ris2021/CRISS/HARDWARE/GPIO-LPT-ASS.png

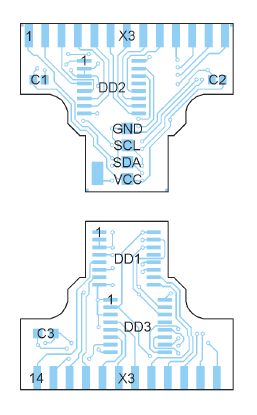
HARDWARE/GPIO-LPT-ASS.png
