ris2021/CRISS/HARDWARE/GPIO-LPT.png

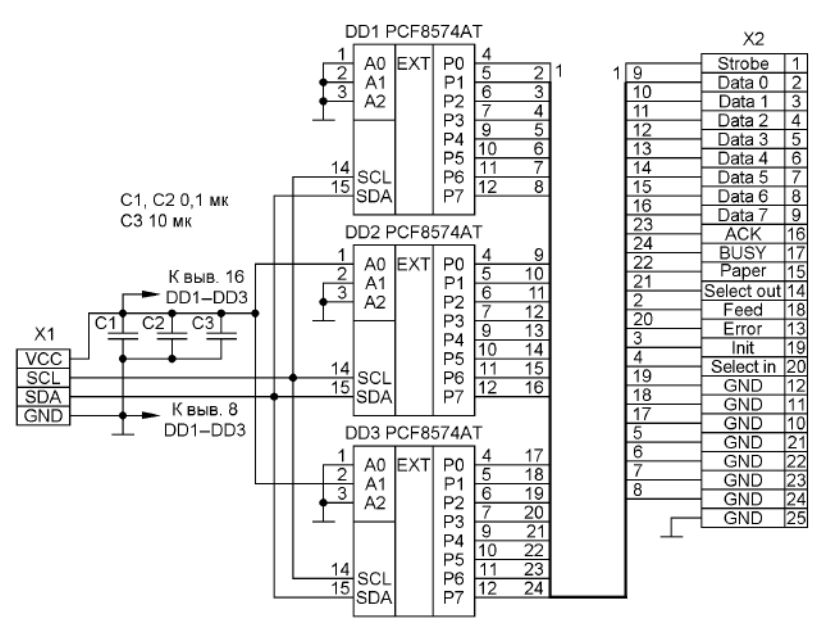
HARDWARE/GPIO-LPT.png
