ris2021/CRISS/HARDWARE/schematic9.png

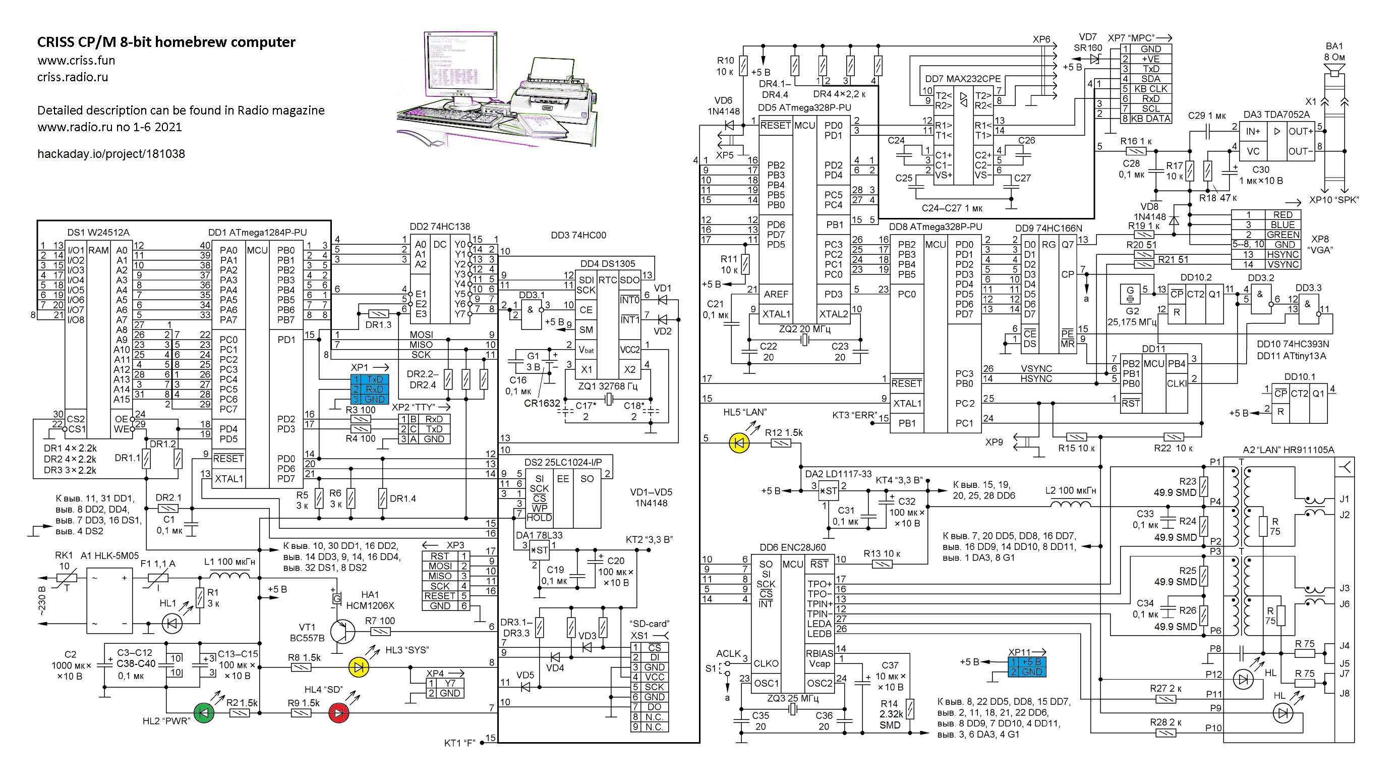
HARDWARE/schematic9.png
