ris2021/CRISS/(list of files, cad)

Other CAD files:
VGA-AT13/at13.obj
