ris2021/CRISS/HARDWARE/PCB_317_assembling_3.png

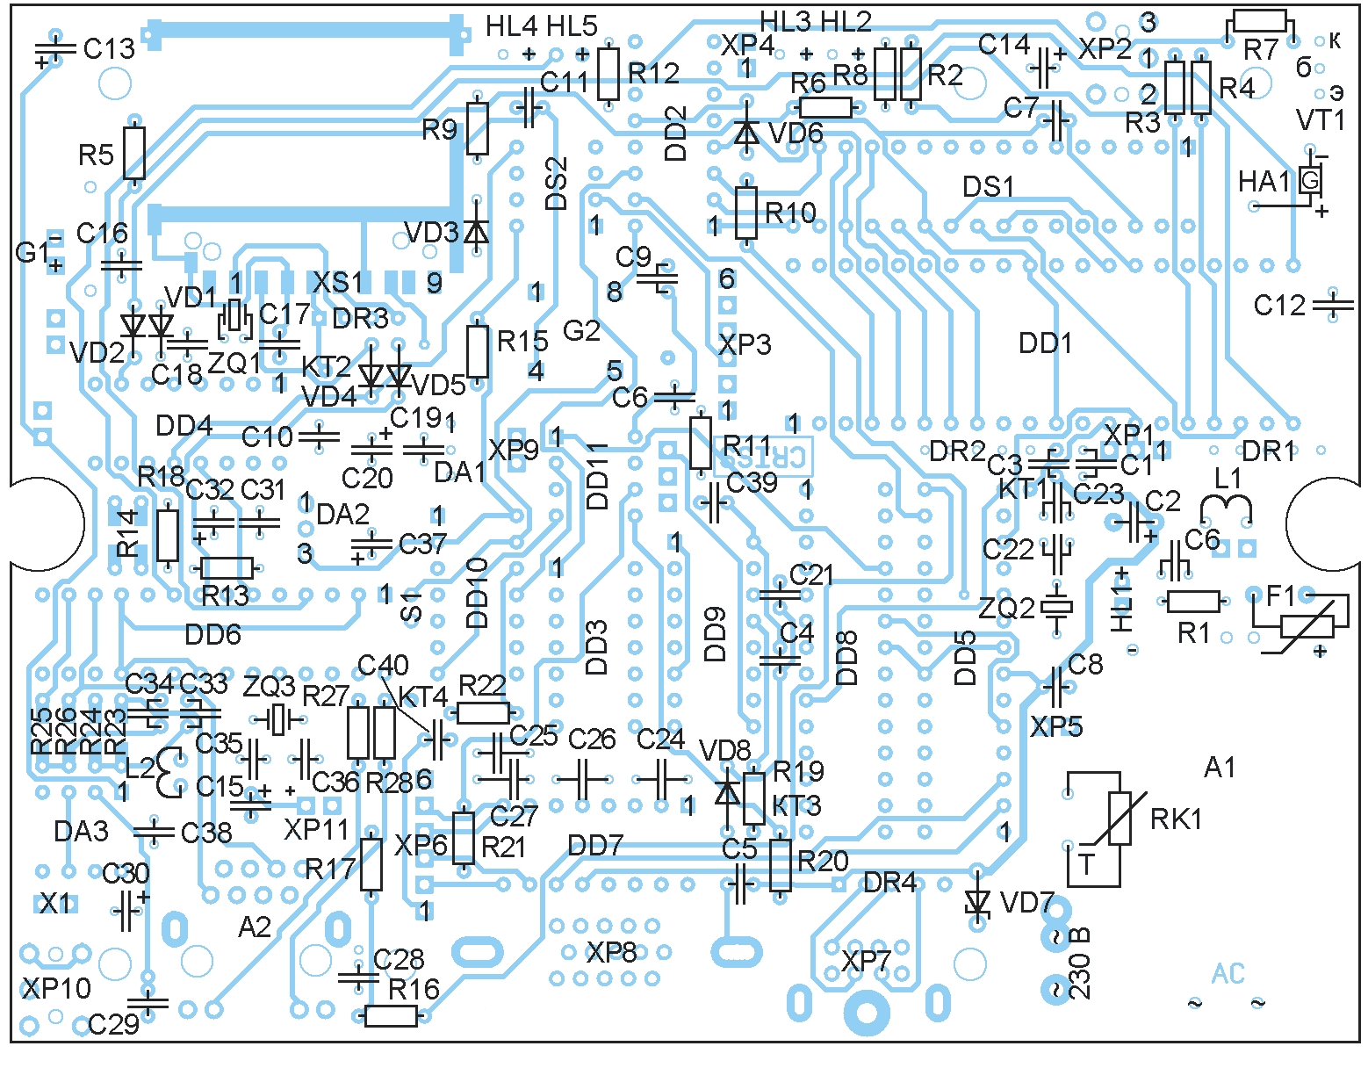
HARDWARE/PCB_317_assembling_3.png
