ris2021/CRISS/FIRMWARE/VGA/v.1.24/changelog.txt

1.24 16.01.2023
----------------------------------------------------------------------------------------
* fixed bug with special mode settings

1.23 04.02.2022
----------------------------------------------------------------------------------------
+ добавлены видережимы 30 и 31 строки с выводом 64 символов в строке
* установки CBYTE вынесена в процедуру

1.22 05.11.2021
----------------------------------------------------------------------------------------
* переписана логика управления кодовыми страницами
+ добавлен режим кодовой страницы 7 - своя КП для каждой строки (в строке 25)

1.21 04.10.2021
----------------------------------------------------------------------------------------
+ добавлен режим отключения синхроимпульсов при vstat=0

1.18 24.02.2021
----------------------------------------------------------------------------------------
* исправлена ошибка - не работала первичная настройка видеорежима
* заменён стартовый экран на cpm inside

1.17 22.02.2021
----------------------------------------------------------------------------------------
* дополнены шрифты CP0, CP2

1.16 19.02.2021
----------------------------------------------------------------------------------------
+ добавлена инициализация PC1 low при старте

1.14 30.01.2021
----------------------------------------------------------------------------------------
+ в стартовом экране первый байт теперь = настройка видеорежима
+ в обработчик стартовой страницы добавнеа обработка табуляции #9

1.13 28.01.2021
----------------------------------------------------------------------------------------
+ добавлен шрифт с меликми точками (#4)

1.11. 22.01.2021
----------------------------------------------------------------------------------------
+ Запущено переключение числа строк и знакогенератора

v.1.7 22.09.2020
----------------------------------------------------------------------------------------
+ Добавлено сохранение SREG в прерываниях, выделен регистр _sreg для сохранения
