ris2021/CRISS/HARDWARE/Panels.pdf

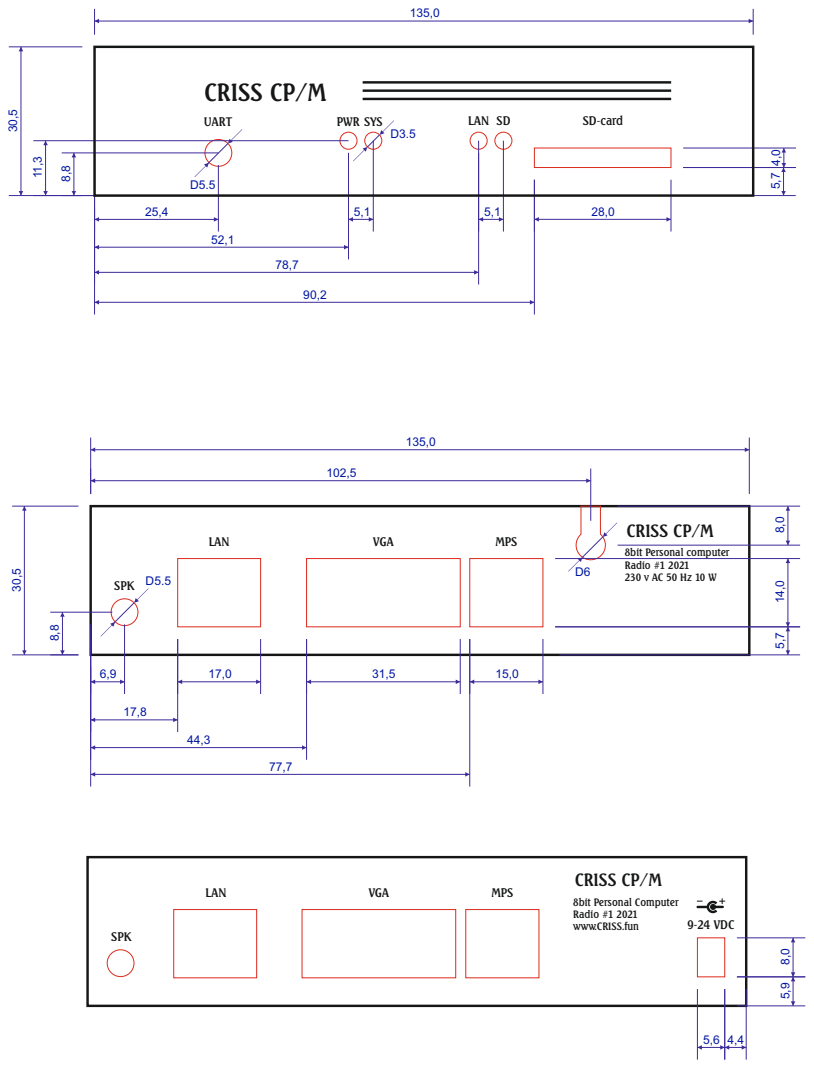
[picture p7: page 1]
SPK; CRISS CP/M LAN; VGA; MPS; 8bit Personal computer Radio #1 2021 230 v AC 50 Hz 10 W; UART; PWR SYS; LAN SD; SD-card; CRISS CP/M; LAN; 8bit Personal Computer Radio #1 2021; www.CRISS.fun; 9-24 VDC
