ris2021/CRISS/FIRMWARE/CPU/v.4.66/z80/z80_asm_ecseg.asm

zOPCODE__LABELS_L: .DB low(zCMD_00),low(zCMD_01),low(zCMD_02),low(zCMD_03),low(zCMD_04),low(zCMD_05),low(zCMD_06),low(zCMD_07),low(zCMD_08),low(zCMD_09),low(zCMD_0a),low(zCMD_0b),low(zCMD_0c),low(zCMD_0d),low(zCMD_0e),low(zCMD_0f),low(zCMD_10),low(zCMD_11),low(zCMD_12),low(zCMD_13),low(zCMD_14),low(zCMD_15),low(zCMD_16),low(zCMD_17),low(zCMD_18),low(zCMD_19),low(zCMD_1a),low(zCMD_1b),low(zCMD_1c),low(zCMD_1d),low(zCMD_1e),low(zCMD_1f),low(zCMD_20),low(zCMD_21),low(zCMD_22),low(zCMD_23),low(zCMD_24),low(zCMD_25),low(zCMD_26),low(zCMD_27),low(zCMD_28),low(zCMD_29),low(zCMD_2a),low(zCMD_2b),low(zCMD_2c),low(zCMD_2d),low(zCMD_2e),low(zCMD_2f),low(zCMD_30),low(zCMD_31),low(zCMD_32),low(zCMD_33),low(zCMD_34),low(zCMD_35),low(zCMD_36),low(zCMD_37),low(zCMD_38),low(zCMD_39),low(zCMD_3a),low(zCMD_3b),low(zCMD_3c),low(zCMD_3d),low(zCMD_3e),low(zCMD_3f),low(zCMD_40),low(zCMD_41),low(zCMD_42),low(zCMD_43),low(zCMD_44),low(zCMD_45),low(zCMD_46),low(zCMD_47),low(zCMD_48),low(zCMD_49),low(zCMD_4a),low(zCMD_4b),low(zCMD_4c),low(zCMD_4d),low(zCMD_4e),low(zCMD_4f),low(zCMD_50),low(zCMD_51),low(zCMD_52),low(zCMD_53),low(zCMD_54),low(zCMD_55),low(zCMD_56),low(zCMD_57),low(zCMD_58),low(zCMD_59),low(zCMD_5a),low(zCMD_5b),low(zCMD_5c),low(zCMD_5d),low(zCMD_5e),low(zCMD_5f),low(zCMD_60),low(zCMD_61),low(zCMD_62),low(zCMD_63),low(zCMD_64),low(zCMD_65),low(zCMD_66),low(zCMD_67),low(zCMD_68),low(zCMD_69),low(zCMD_6a),low(zCMD_6b),low(zCMD_6c),low(zCMD_6d),low(zCMD_6e),low(zCMD_6f),low(zCMD_70),low(zCMD_71),low(zCMD_72),low(zCMD_73),low(zCMD_74),low(zCMD_75),low(zCMD_76),low(zCMD_77),low(zCMD_78),low(zCMD_79),low(zCMD_7a),low(zCMD_7b),low(zCMD_7c),low(zCMD_7d),low(zCMD_7e),low(zCMD_7f),low(zCMD_80),low(zCMD_81),low(zCMD_82),low(zCMD_83),low(zCMD_84),low(zCMD_85),low(zCMD_86),low(zCMD_87),low(zCMD_88),low(zCMD_89),low(zCMD_8a),low(zCMD_8b),low(zCMD_8c),low(zCMD_8d),low(zCMD_8e),low(zCMD_8f),low(zCMD_90),low(zCMD_91),low(zCMD_92),low(zCMD_93),low(zCMD_94),low(zCMD_95),low(zCMD_96),low(zCMD_97),low(zCMD_98),low(zCMD_99),low(zCMD_9a),low(zCMD_9b),low(zCMD_9c),low(zCMD_9d),low(zCMD_9e),low(zCMD_9f),low(zCMD_a0),low(zCMD_a1),low(zCMD_a2),low(zCMD_a3),low(zCMD_a4),low(zCMD_a5),low(zCMD_a6),low(zCMD_a7),low(zCMD_a8),low(zCMD_a9),low(zCMD_aa),low(zCMD_ab),low(zCMD_ac),low(zCMD_ad),low(zCMD_ae),low(zCMD_af),low(zCMD_b0),low(zCMD_b1),low(zCMD_b2),low(zCMD_b3),low(zCMD_b4),low(zCMD_b5),low(zCMD_b6),low(zCMD_b7),low(zCMD_b8),low(zCMD_b9),low(zCMD_ba),low(zCMD_bb),low(zCMD_bc),low(zCMD_bd),low(zCMD_be),low(zCMD_bf),low(zCMD_c0),low(zCMD_c1),low(zCMD_c2),low(zCMD_c3),low(zCMD_c4),low(zCMD_c5),low(zCMD_c6),low(zCMD_c7),low(zCMD_c8),low(zCMD_c9),low(zCMD_ca),low(zCMD_cb),low(zCMD_cc),low(zCMD_cd),low(zCMD_ce),low(zCMD_cf),low(zCMD_d0),low(zCMD_d1),low(zCMD_d2),low(zCMD_d3),low(zCMD_d4),low(zCMD_d5),low(zCMD_d6),low(zCMD_d7),low(zCMD_d8),low(zCMD_d9),low(zCMD_da),low(zCMD_db),low(zCMD_dc),low(zCMD_dd),low(zCMD_de),low(zCMD_df),low(zCMD_e0),low(zCMD_e1),low(zCMD_e2),low(zCMD_e3),low(zCMD_e4),low(zCMD_e5),low(zCMD_e6),low(zCMD_e7),low(zCMD_e8),low(zCMD_e9),low(zCMD_ea),low(zCMD_eb),low(zCMD_ec),low(zCMD_ed),low(zCMD_ee),low(zCMD_ef),low(zCMD_f0),low(zCMD_f1),low(zCMD_f2),low(zCMD_f3),low(zCMD_f4),low(zCMD_f5),low(zCMD_f6),low(zCMD_f7),low(zCMD_f8),low(zCMD_f9),low(zCMD_fa),low(zCMD_fb),low(zCMD_fc),low(zCMD_fd),low(zCMD_fe),low(zCMD_ff)
zOPCODE__LABELS_H: .DB high(zCMD_00),high(zCMD_01),high(zCMD_02),high(zCMD_03),high(zCMD_04),high(zCMD_05),high(zCMD_06),high(zCMD_07),high(zCMD_08),high(zCMD_09),high(zCMD_0a),high(zCMD_0b),high(zCMD_0c),high(zCMD_0d),high(zCMD_0e),high(zCMD_0f),high(zCMD_10),high(zCMD_11),high(zCMD_12),high(zCMD_1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


zOPCODE_CB_LABELS_L: .DB low(zCMDCB_00),low(zCMDCB_01),low(zCMDCB_02),low(zCMDCB_03),low(zCMDCB_04),low(zCMDCB_05),low(zCMDCB_06),low(zCMDCB_07),low(zCMDCB_08),low(zCMDCB_09),low(zCMDCB_0a),low(zCMDCB_0b),low(zCMDCB_0c),low(zCMDCB_0d),low(zCMDCB_0e),low(zCMDCB_0f),low(zCMDCB_10),low(zCMDCB_11),low(z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
zOPCODE_CB_LABELS_H: .DB high(zCMDCB_00),high(zCMDCB_01),high(zCMDCB_02),high(zCMDCB_03),high(zCMDCB_04),high(zCMDCB_05),high(zCMDCB_06),high(zCMDCB_07),high(zCMDCB_08),high(zCMDCB_09),high(zCMDCB_0a),high(zCMDCB_0b),high(zCMDCB_0c),high(zCMDCB_0d),high(zCMDCB_0e),high(zCMDCB_0f),high(zCMDCB_10),hig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


zOPCODE_DD_LABELS_L: .DB low(zCMDDD_00),low(zCMDDD_01),low(zCMDDD_02),low(zCMDDD_03),low(zCMDDD_04),low(zCMDDD_05),low(zCMDDD_06),low(zCMDDD_07),low(zCMDDD_08),low(zCMDDD_09),low(zCMDDD_0a),low(zCMDDD_0b),low(zCMDDD_0c),low(zCMDDD_0d),low(zCMDDD_0e),low(zCMDDD_0f),low(zCMDDD_10),low(zCMDDD_11),low(z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
zOPCODE_DD_LABELS_H: .DB high(zCMDDD_00),high(zCMDDD_01),high(zCMDDD_02),high(zCMDDD_03),high(zCMDDD_04),high(zCMDDD_05),high(zCMDDD_06),high(zCMDDD_07),high(zCMDDD_08),high(zCMDDD_09),high(zCMDDD_0a),high(zCMDDD_0b),high(zCMDDD_0c),high(zCMDDD_0d),high(zCMDDD_0e),high(zCMDDD_0f),high(zCMDDD_10),hig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


zOPCODE_ED_LABELS_L: .DB low(zCMDED_00),low(zCMDED_01),low(zCMDED_02),low(zCMDED_03),low(zCMDED_04),low(zCMDED_05),low(zCMDED_06),low(zCMDED_07),low(zCMDED_08),low(zCMDED_09),low(zCMDED_0a),low(zCMDED_0b),low(zCMDED_0c),low(zCMDED_0d),low(zCMDED_0e),low(zCMDED_0f),low(zCMDED_10),low(zCMDED_11),low(z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
zOPCODE_ED_LABELS_H: .DB high(zCMDED_00),high(zCMDED_01),high(zCMDED_02),high(zCMDED_03),high(zCMDED_04),high(zCMDED_05),high(zCMDED_06),high(zCMDED_07),high(zCMDED_08),high(zCMDED_09),high(zCMDED_0a),high(zCMDED_0b),high(zCMDED_0c),high(zCMDED_0d),high(zCMDED_0e),high(zCMDED_0f),high(zCMDED_10),hig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


zOPCODE_FD_LABELS_L: .DB low(zCMDFD_00),low(zCMDFD_01),low(zCMDFD_02),low(zCMDFD_03),low(zCMDFD_04),low(zCMDFD_05),low(zCMDFD_06),low(zCMDFD_07),low(zCMDFD_08),low(zCMDFD_09),low(zCMDFD_0a),low(zCMDFD_0b),low(zCMDFD_0c),low(zCMDFD_0d),low(zCMDFD_0e),low(zCMDFD_0f),low(zCMDFD_10),low(zCMDFD_11),low(z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
zOPCODE_FD_LABELS_H: .DB high(zCMDFD_00),high(zCMDFD_01),high(zCMDFD_02),high(zCMDFD_03),high(zCMDFD_04),high(zCMDFD_05),high(zCMDFD_06),high(zCMDFD_07),high(zCMDFD_08),high(zCMDFD_09),high(zCMDFD_0a),high(zCMDFD_0b),high(zCMDFD_0c),high(zCMDFD_0d),high(zCMDFD_0e),high(zCMDFD_0f),high(zCMDFD_10),hig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


zOPCODE_DDCB_LABELS_L: .DB low(zCMD_NONI),low(zCMD_NONI),low(zCMD_NONI),low(zCMD_NONI),low(zCMD_NONI),low(zCMD_NONI),low(zCMDDDCB_06),low(zCMD_NONI),low(zCMD_NONI),low(zCMD_NONI),low(zCMD_NONI),low(zCMD_NONI),low(zCMD_NONI),low(zCMD_NONI),low(zCMDDDCB_0e),low(zCMD_NONI),low(zCMD_NONI),low(zCMD_NONI)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
zOPCODE_DDCB_LABELS_H: .DB high(zCMD_NONI),high(zCMD_NONI),high(zCMD_NONI),high(zCMD_NONI),high(zCMD_NONI),high(zCMD_NONI),high(zCMDDDCB_06),high(zCMD_NONI),high(zCMD_NONI),high(zCMD_NONI),high(zCMD_NONI),high(zCMD_NONI),high(zCMD_NONI),high(zCMD_NONI),high(zCMDDDCB_0e),high(zCMD_NONI),high(zCMD_NONI),high(zCMD_NONI),high(zCMD_NONI),high(zCMD_NONI),high(zCMD_NONI),high(zCMD_NONI),high(zCMDDDCB_16),high(zCMD_NONI),high(zCMD_NONI),high(zCMD_NONI),high(zCMD_NONI),high(zCMD_NONI),high(zCMD_NONI),high(zCMD_NONI),high(zCMDDDCB_1e),high(zCMD_NONI),high(zCMD_NONI),high(zCMD_NONI),high(zCMD_NONI),high(zCMD_NONI),high(zCMD_NONI),high(zCMD_NONI),high(zCMDDDCB_26),high(zCMD_NONI),high(zCMD_NONI),high(zCMD_NONI),high(zCMD_NONI),high(zCMD_NONI),high(zCMD_NONI),high(zCMD_NONI),high(zCMDDDCB_2e),high(zCMD_NONI),high(zCMD_NONI),high(zCMD_NONI),high(zCMD_NONI),high(zCMD_NONI),high(zCMD_NONI),high(zCMD_NONI),high(zCMDDDCB_36),high(zCMD_NONI),high(zCMD_NONI),high(zCMD_NONI),high(zCMD_NONI),high(zCMD_NONI),high(zCMD_NONI),high(zCMD_NONI),high(zCMDDDCB_3e),high(zCMD_NONI),high(zCMD_NONI),high(zCMD_NONI),high(zCMD_NONI),high(zCMD_NONI),high(zCMD_NONI),high(zCMD_NONI),high(zCMDDDCB_46),high(zCMD_NONI),high(zCMD_NONI),high(zCMD_NONI),high(zCMD_NONI),high(zCMD_NONI),high(zCMD_NONI),high(zCMD_NONI),high(zCMDDDCB_4e),high(zCMD_NONI),high(zCMD_NONI),high(zCMD_NONI),high(zCMD_NONI),high(zCMD_NONI),high(zCMD_NONI),high(zCMD_NONI),high(zCMDDDCB_56),high(zCMD_NONI),high(zCMD_NONI),high(zCMD_NONI),high(zCMD_N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
low(zCMD_NONI),low(zCMD_NONI),low(zCMD_NONI),low(zCMDFDCB_c6),low(zCMD_NONI),low(zCMD_NONI),low(zCMD_NONI),low(zCMD_NONI),low(zCMD_NONI),low(zCMD_NONI),low(zCMD_NONI),low(zCMDFDCB_ce),low(zCMD_NONI),low(zCMD_NONI),low(zCMD_NONI),low(zCMD_NONI),low(zCMD_NONI),low(zCMD_NONI),low(zCMD_NONI),low(zCMDFDCB_d6),low(zCMD_NONI),low(zCMD_NONI),low(zCMD_NONI),low(zCMD_NONI),low(zCMD_NONI),low(zCMD_NONI),low(zCMD_NONI),low(zCMDFDCB_de),low(zCMD_NONI),low(zCMD_NONI),low(zCMD_NONI),low(zCMD_NONI),low(zCMD_NONI),low(zCMD_NONI),low(zCMD_NONI),low(zCMDFDCB_e6),low(zCMD_NONI),low(zCMD_NONI),low(zCMD_NONI),low(zCMD_NONI),low(zCMD_NONI),low(zCMD_NONI),low(zCMD_NONI),low(zCMDFDCB_ee),low(zCMD_NONI),low(zCMD_NONI),low(zCMD_NONI),low(zCMD_NONI),low(zCMD_NONI),low(zCMD_NONI),low(zCMD_NONI),low(zCMDFDCB_f6),low(zCMD_NONI),low(zCMD_NONI),low(zCMD_NONI),low(zCMD_NONI),low(zCMD_NONI),low(zCMD_NONI),low(zCMD_NONI),low(zCMDFDCB_fe),low(zCMD_NONI)
zOPCODE_FDCB_LABELS_H: .DB high(zCMD_NONI),high(zCMD_NONI),high(zCMD_NONI),high(zCMD_NONI),high(zCMD_NONI),high(zCMD_NONI),high(zCMDFDCB_06),high(zCMD_NONI),high(zCMD_NONI),high(zCMD_NONI),high(zCMD_NONI),high(zCMD_NONI),high(zCMD_NONI),high(zCMD_NONI),high(zCMDFDCB_0e),high(zCMD_NONI),high(zCMD_NONI),high(zCMD_NONI),high(zCMD_NONI),high(zCMD_NONI),high(zCMD_NONI),high(zCMD_NONI),high(zCMDFDCB_16),high(zCMD_NONI),high(zCMD_NONI),high(zCMD_NONI),high(zCMD_NONI),high(zCMD_NONI),high(zCMD_NONI),high(zCMD_NONI),high(zCMDFDCB_1e),high(zCMD_NONI),high(zCMD_NONI),high(zCMD_NONI),high(zCMD_NONI),high(zCMD_NONI),high(zCMD_NONI),high(zCMD_NONI),high(zCMDFDCB_26),high(zCMD_NONI),high(zCMD_NONI),high(zCMD_NONI),high(zCMD_NONI),high(zCMD_NONI),high(zCMD_NONI),high(zCMD_NONI),high(zCMDFDCB_2e),high(zCMD_NONI),high(zCMD_NONI),high(zCMD_NONI),high(zCMD_NONI),high(zCMD_NONI),high(zCMD_NONI),high(zCMD_NONI),high(zCMDFDCB_36),high(zCMD_NONI),high(zCMD_NONI),high(zCMD_NONI),high(zCMD_NONI),high(zCMD_NONI),high(zCMD_NONI),high(zCMD_NONI),high(zCMDFDCB_3e),high(zCMD_NONI),high(zCMD_NONI),high(zCMD_NONI),high(zCMD_NONI),high(zCMD_NONI),high(zCMD_NONI),high(zCMD_NONI),high(zCMDFDCB_46),high(zCMD_NONI),high(zCMD_NONI),high(zCMD_NONI),high(zCMD_NONI),high(zCMD_NONI),high(zCMD_NONI),high(zCMD_NONI),high(zCMDFDCB_4e),high(zCMD_NONI),high(zCMD_NONI),high(zCMD_NONI),high(zCMD_NONI),high(zCMD_NONI),high(zCMD_NONI),high(zCMD_NONI),high(zCMDFDCB_56),high(zCMD_NONI),high(zCMD_NONI),high(zCMD_NONI),high(zCMD_N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
