ris2021/CRISS/FIRMWARE/CPU/v.4.66/z80/z80_daadata.asm

DAA_ACC:
	.DB	0x00,0x01,0x02,0x03,0x04,0x05,0x06,0x07,0x08,0x09,0x10,0x11,0x12,0x13,0x14,0x15
	.DB	0x10,0x11,0x12,0x13,0x14,0x15,0x16,0x17,0x18,0x19,0x20,0x21,0x22,0x23,0x24,0x25
	.DB	0x20,0x21,0x22,0x23,0x24,0x25,0x26,0x27,0x28,0x29,0x30,0x31,0x32,0x33,0x34,0x35
	.DB	0x30,0x31,0x32,0x33,0x34,0x35,0x36,0x37,0x38,0x39,0x40,0x41,0x42,0x43,0x44,0x45
	.DB	0x40,0x41,0x42,0x43,0x44,0x45,0x46,0x47,0x48,0x49,0x50,0x51,0x52,0x53,0x54,0x55
	.DB	0x50,0x51,0x52,0x53,0x54,0x55,0x56,0x57,0x58,0x59,0x60,0x61,0x62,0x63,0x64,0x65
	.DB	0x60,0x61,0x62,0x63,0x64,0x65,0x66,0x67,0x68,0x69,0x70,0x71,0x72,0x73,0x74,0x75
	.DB	0x70,0x71,0x72,0x73,0x74,0x75,0x76,0x77,0x78,0x79,0x80,0x81,0x82,0x83,0x84,0x85
	.DB	0x80,0x81,0x82,0x83,0x84,0x85,0x86,0x87,0x88,0x89,0x90,0x91,0x92,0x93,0x94,0x95
	.DB	0x90,0x91,0x92,0x93,0x94,0x95,0x96,0x97,0x98,0x99,0x00,0x01,0x02,0x03,0x04,0x05
	.DB	0x00,0x01,0x02,0x03,0x04,0x05,0x06,0x07,0x08,0x09,0x10,0x11,0x12,0x13,0x14,0x15
	.DB	0x10,0x11,0x12,0x13,0x14,0x15,0x16,0x17,0x18,0x19,0x20,0x21,0x22,0x23,0x24,0x25
	.DB	0x20,0x21,0x22,0x23,0x24,0x25,0x26,0x27,0x28,0x29,0x30,0x31,0x32,0x33,0x34,0x35
	.DB	0x30,0x31,0x32,0x33,0x34,0x35,0x36,0x37,0x38,0x39,0x40,0x41,0x42,0x43,0x44,0x45
	.DB	0x40,0x41,0x42,0x43,0x44,0x45,0x46,0x47,0x48,0x49,0x50,0x51,0x52,0x53,0x54,0x55
	.DB	0x50,0x51,0x52,0x53,0x54,0x55,0x56,0x57,0x58,0x59,0x60,0x61,0x62,0x63,0x64,0x65
	.DB	0x06,0x07,0x08,0x09,0x0a,0x0b,0x0c,0x0d,0x0e,0x0f,0x10,0x11,0x12,0x13,0x14,0x15
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
	.DB	0xe5,0xed,0xe5,0xed,0xed,0xe5,0xcd,0xc5,0xc5,0xcd,0xc5,0xcd,0xcd,0xc5,0xc5,0xcd
	.DB	0xed,0xe5,0xed,0xe5,0xe5,0xed,0xc5,0xcd,0xcd,0xc5,0xcd,0xc5,0xc5,0xcd,0xcd,0xc5
	.DB	0xe5,0xed,0xe5,0xed,0xed,0xe5,0xc5,0xcd,0xcd,0xc5,0xcd,0xc5,0xc5,0xcd,0xcd,0xc5
	.DB	0xe5,0xed,0xe5,0xed,0xed,0xe5,0xcd,0xc5,0xc5,0xcd,0xc5,0xcd,0xcd,0xc5,0xc5,0xcd
	.DB	0xed,0xe5,0xed,0xe5,0xe5,0xed,0xcb,0xc1,0xc1,0xc9,0xc1,0xc9,0xc9,0xc1,0xc1,0xc9
	.DB	0xe9,0xe1,0xe9,0xe1,0xe1,0xe9,0xc1,0xc9,0xc9,0xc1,0xc9,0xc1,0xc1,0xc9,0xc9,0xc1
	.DB	0xe1,0xe9,0xe1,0xe9,0xe9,0xe1,0xc1,0xc9,0xc9,0xc1,0xc9,0xc1,0xc1,0xc9,0xc9,0xc1
	.DB	0xe1,0xe9,0xe1,0xe9,0xe9,0xe1,0xc9,0xc1,0xc1,0xc9,0xc1,0xc9,0xc9,0xc1,0xc1,0xc9
	.DB	0xe9,0xe1,0xe9,0xe1,0xe1,0xe9,0xc1,0xc9,0xc9,0xc1,0xc9,0xc1,0xc1,0xc9,0xc9,0xc1
	.DB	0xe1,0xe9,0xe1,0xe9,0xe9,0xe1,0xc9,0xc1,0xc1,0xc9,0xc1,0xc9,0xc9,0xc1,0xc1,0xc9
	.DB	0xe9,0xe1,0xe9,0xe1,0xe1,0xe9,0xc9,0xc1,0xc1,0xc9,0xc1,0xc9,0xc9,0xc1,0xc1,0xc9
	.DB	0xe9,0xe1,0xe9,0xe1,0xe1,0xe9,0xc1,0xc9,0xc9,0xc1,0xc9,0xc1,0xc1,0xc9,0xc9,0xc1
	.DB	0xe1,0xe9,0xe1,0xe9,0xe9,0xe1,0xc5,0xcd,0xcd,0xc5,0xcd,0xc5,0xc5,0xcd,0xcd,0xc5
	.DB	0xe5,0xed,0xe5,0xed,0xed,0xe5,0xcd,0xc5,0xc5,0xcd,0xc5,0xcd,0xcd,0xc5,0xc5,0xcd
