ris2021/CRISS/FIRMWARE/VGA/v.1.24/CP1_font8x20-256.asm

cp1_CHARPIXTABLE:
cp1_LINE0:
	.DB 0x00,0x70,0x07,0x77,0x00,0x70,0x07,0x77,0x00,0x70,0x07,0x77,0x00,0x70,0x07,0x77
	.DB 0x00,0x70,0x07,0x77,0x00,0x70,0x07,0x77,0x00,0x70,0x07,0x77,0x00,0x70,0x07,0x77
	.DB 0x00,0x70,0x07,0x77,0x00,0x70,0x07,0x77,0x00,0x70,0x07,0x77,0x00,0x70,0x07,0x77
	.DB 0x00,0x70,0x07,0x77,0x00,0x70,0x07,0x77,0x00,0x70,0x07,0x77,0x00,0x70,0x07,0x77
	.DB 0x00,0x70,0x07,0x77,0x00,0x70,0x07,0x77,0x00,0x70,0x07,0x77,0x00,0x70,0x07,0x77
	.DB 0x00,0x70,0x07,0x77,0x00,0x70,0x07,0x77,0x00,0x70,0x07,0x77,0x00,0x70,0x07,0x77
	.DB 0x00,0x70,0x07,0x77,0x00,0x70,0x07,0x77,0x00,0x70,0x07,0x77,0x00,0x70,0x07,0x77
	.DB 0x00,0x70,0x07,0x77,0x00,0x70,0x07,0x77,0x00,0x70,0x07,0x77,0x00,0x70,0x07,0x77
	.DB 0x00,0x70,0x07,0x77,0x00,0x70,0x07,0x77,0x00,0x70,0x07,0x77,0x00,0x70,0x07,0x77
	.DB 0x00,0x70,0x07,0x77,0x00,0x70,0x07,0x77,0x00,0x70,0x07,0x77,0x00,0x70,0x07,0x77
	.DB 0x00,0x70,0x07,0x77,0x00,0x70,0x07,0x77,0x00,0x70,0x07,0x77,0x00,0x70,0x07,0x77
	.DB 0x00,0x70,0x07,0x77,0x00,0x70,0x07,0x77,0x00,0x70,0x07,0x77,0x00,0x70,0x07,0x77
	.DB 0x00,0x70,0x07,0x77,0x00,0x70,0x07,0x77,0x00,0x70,0x07,0x77,0x00,0x70,0x07,0x77
	.DB 0x00,0x70,0x07,0x77,0x00,0x70,0x07,0x77,0x00,0x70,0x07,0x77,0x00,0x70,0x07,0x77
	.DB 0x00,0x70,0x07,0x77,0x00,0x70,0x07,0x77,0x00,0x70,0x07,0x77,0x00,0x70,0x07,0x77
	.DB 0x00,0x70,0x07,0x77,0x00,0x70,0x07,0x77,0x00,0x70,0x07,0x77,0x00,0x70,0x07,0x77
cp1_LINE1:
	.DB 0x00,0x70,0x07,0x77,0x00,0x70,0x07,0x77,0x00,0x70,0x07,0x77,0x00,0x70,0x07,0x77
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
	.DB 0x00,0x00,0x00,0x00,0x00,0x00,0x00,0x00,0x00,0x00,0x00,0x00,0x00,0x00,0x00,0x00
	.DB 0x00,0x00,0x00,0x00,0x00,0x00,0x00,0x00,0x00,0x00,0x00,0x00,0x00,0x00,0x00,0x00
	.DB 0x00,0x00,0x00,0x00,0x00,0x00,0x00,0x00,0x00,0x00,0x00,0x00,0x00,0x00,0x00,0x00
	.DB 0x00,0x00,0x00,0x00,0x00,0x00,0x00,0x00,0x00,0x00,0x00,0x00,0x00,0x00,0x00,0x00
	.DB 0x00,0x00,0x00,0x00,0x00,0x00,0x00,0x00,0x00,0x00,0x00,0x00,0x00,0x00,0x00,0x00
	.DB 0x00,0x00,0x00,0x00,0x00,0x00,0x00,0x00,0x00,0x00,0x00,0x00,0x00,0x00,0x00,0x00
	.DB 0x00,0x00,0x00,0x00,0x00,0x00,0x00,0x00,0x00,0x00,0x00,0x00,0x00,0x00,0x00,0x00
	.DB 0x00,0x00,0x00,0x00,0x00,0x00,0x00,0x00,0x00,0x00,0x00,0x00,0x00,0x00,0x00,0x00
	.DB 0x00,0x00,0x00,0x00,0x00,0x00,0x00,0x00,0x00,0x00,0x00,0x00,0x00,0x00,0x00,0x00
	.DB 0x00,0x00,0x00,0x00,0x00,0x00,0x00,0x00,0x00,0x00,0x00,0x00,0x00,0x00,0x00,0x00
