ris2021/CRISS/FIRMWARE/VGA/v.1.24/CP4_font8x20-256.asm

CP4_CHARPIXTABLE:
CP5_LINE0:
	.DB 0x00,0x20,0x02,0x22,0x00,0x20,0x02,0x22,0x00,0x20,0x02,0x22,0x00,0x20,0x02,0x22
	.DB 0x00,0x20,0x02,0x22,0x00,0x20,0x02,0x22,0x00,0x20,0x02,0x22,0x00,0x20,0x02,0x22
	.DB 0x00,0x20,0x02,0x22,0x00,0x20,0x02,0x22,0x00,0x20,0x02,0x22,0x00,0x20,0x02,0x22
	.DB 0x00,0x20,0x02,0x22,0x00,0x20,0x02,0x22,0x00,0x20,0x02,0x22,0x00,0x20,0x02,0x22
	.DB 0x00,0x20,0x02,0x22,0x00,0x20,0x02,0x22,0x00,0x20,0x02,0x22,0x00,0x20,0x02,0x22
	.DB 0x00,0x20,0x02,0x22,0x00,0x20,0x02,0x22,0x00,0x20,0x02,0x22,0x00,0x20,0x02,0x22
	.DB 0x00,0x20,0x02,0x22,0x00,0x20,0x02,0x22,0x00,0x20,0x02,0x22,0x00,0x20,0x02,0x22
	.DB 0x00,0x20,0x02,0x22,0x00,0x20,0x02,0x22,0x00,0x20,0x02,0x22,0x00,0x20,0x02,0x22
	.DB 0x00,0x20,0x02,0x22,0x00,0x20,0x02,0x22,0x00,0x20,0x02,0x22,0x00,0x20,0x02,0x22
	.DB 0x00,0x20,0x02,0x22,0x00,0x20,0x02,0x22,0x00,0x20,0x02,0x22,0x00,0x20,0x02,0x22
	.DB 0x00,0x20,0x02,0x22,0x00,0x20,0x02,0x22,0x00,0x20,0x02,0x22,0x00,0x20,0x02,0x22
	.DB 0x00,0x20,0x02,0x22,0x00,0x20,0x02,0x22,0x00,0x20,0x02,0x22,0x00,0x20,0x02,0x22
	.DB 0x00,0x20,0x02,0x22,0x00,0x20,0x02,0x22,0x00,0x20,0x02,0x22,0x00,0x20,0x02,0x22
	.DB 0x00,0x20,0x02,0x22,0x00,0x20,0x02,0x22,0x00,0x20,0x02,0x22,0x00,0x20,0x02,0x22
	.DB 0x00,0x20,0x02,0x22,0x00,0x20,0x02,0x22,0x00,0x20,0x02,0x22,0x00,0x20,0x02,0x22
	.DB 0x00,0x20,0x02,0x22,0x00,0x20,0x02,0x22,0x00,0x20,0x02,0x22,0x00,0x20,0x02,0x22
CP5_LINE1:
	.DB 0x00,0x70,0x07,0x77,0x00,0x70,0x07,0x77,0x00,0x70,0x07,0x77,0x00,0x70,0x07,0x77
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
	.DB 0x00,0x00,0x00,0x00,0x00,0x00,0x00,0x00,0x00,0x00,0x00,0x00,0x00,0x00,0x00,0x00
	.DB 0x00,0x00,0x00,0x00,0x00,0x00,0x00,0x00,0x00,0x00,0x00,0x00,0x00,0x00,0x00,0x00
	.DB 0x00,0x00,0x00,0x00,0x00,0x00,0x00,0x00,0x00,0x00,0x00,0x00,0x00,0x00,0x00,0x00
	.DB 0x00,0x00,0x00,0x00,0x00,0x00,0x00,0x00,0x00,0x00,0x00,0x00,0x00,0x00,0x00,0x00
	.DB 0x00,0x00,0x00,0x00,0x00,0x00,0x00,0x00,0x00,0x00,0x00,0x00,0x00,0x00,0x00,0x00
	.DB 0x00,0x00,0x00,0x00,0x00,0x00,0x00,0x00,0x00,0x00,0x00,0x00,0x00,0x00,0x00,0x00
	.DB 0x00,0x00,0x00,0x00,0x00,0x00,0x00,0x00,0x00,0x00,0x00,0x00,0x00,0x00,0x00,0x00
	.DB 0x00,0x00,0x00,0x00,0x00,0x00,0x00,0x00,0x00,0x00,0x00,0x00,0x00,0x00,0x00,0x00
	.DB 0x00,0x00,0x00,0x00,0x00,0x00,0x00,0x00,0x00,0x00,0x00,0x00,0x00,0x00,0x00,0x00
	.DB 0x00,0x00,0x00,0x00,0x00,0x00,0x00,0x00,0x00,0x00,0x00,0x00,0x00,0x00,0x00,0x00
