ris2021/CRISS/FIRMWARE/VGA/v.1.24/cp0_font8x20-256.asm

CP0_CHARPIXTABLE:
CP0_LINE0:
	.DB 0xff,0x1a,0x00,0xb0,0x1a,0x00,0x00,0x1a,0xb0,0xb0,0x1a,0x00,0xaa,0xb0,0x10,0x1a
	.DB 0x00,0xf0,0x0f,0xff,0x00,0xf0,0x0f,0xff,0x00,0xf0,0x0f,0xff,0x00,0xf0,0x0f,0xff
	.DB 0x00,0x00,0x00,0x00,0x00,0x00,0x00,0x00,0x00,0x00,0x00,0x00,0x00,0x00,0x00,0x00
	.DB 0x00,0x00,0x00,0x00,0x00,0x00,0x00,0x00,0x00,0x00,0x00,0x00,0x00,0x00,0x00,0x00
	.DB 0x00,0x00,0x00,0x00,0x00,0x00,0x00,0x00,0x00,0x00,0x00,0x00,0x00,0x00,0x00,0x00
	.DB 0x00,0x00,0x00,0x00,0x00,0x00,0x00,0x00,0x00,0x00,0x00,0x00,0x00,0x00,0x00,0x00
	.DB 0x00,0x00,0x00,0x00,0x00,0x00,0x00,0x00,0x00,0x00,0x00,0x00,0x00,0x00,0x00,0x00
	.DB 0x00,0x00,0x00,0x00,0x00,0x00,0x00,0x00,0x00,0x00,0x00,0x00,0x00,0x00,0x00,0x00
	.DB 0x00,0x00,0x00,0x00,0x00,0x00,0x00,0x00,0x00,0x00,0x00,0x00,0x00,0x00,0x00,0x00
	.DB 0x00,0x00,0x00,0x00,0x00,0x00,0x00,0x00,0x00,0x00,0x00,0x00,0x00,0x00,0x00,0x00
	.DB 0x00,0x00,0x00,0x00,0x00,0x00,0x00,0x00,0x00,0x00,0x00,0x00,0x00,0x00,0x00,0x00
	.DB 0xaa,0xaa,0xaa,0x10,0x10,0x10,0x24,0x00,0x00,0x24,0x24,0x00,0x24,0x24,0x10,0x00
	.DB 0x10,0x10,0x00,0x10,0x00,0x10,0x10,0x24,0x24,0x00,0x24,0x00,0x24,0x00,0x24,0x10
	.DB 0x24,0x00,0x00,0x24,0x10,0x00,0x00,0x24,0x10,0x10,0x00,0xff,0xff,0xfc,0x3f,0x18
	.DB 0x00,0x00,0x00,0x00,0x00,0x00,0x00,0x00,0x00,0x00,0x00,0x00,0x00,0x00,0x00,0x00
	.DB 0x00,0x00,0x00,0x00,0x00,0x00,0x00,0x00,0x00,0x00,0x00,0x00,0x00,0x00,0x00,0x10
CP0_LINE1:
	.DB 0xff,0x10,0x00,0x10,0x10,0x00,0x00,0x10,0x10,0x10,0x10,0x00,0x00,0x10,0x10,0x10
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
	.DB 0x00,0x00,0x00,0x00,0x00,0x00,0x00,0x00,0x00,0x00,0x00,0x00,0x00,0x00,0x00,0x00
	.DB 0x00,0x00,0x00,0x00,0x00,0x00,0x00,0x00,0x00,0x00,0x00,0x00,0x00,0x00,0x00,0x00
	.DB 0x00,0x00,0x00,0x00,0x00,0x00,0x00,0x00,0x00,0x00,0x00,0x00,0x00,0x00,0x00,0x00
	.DB 0x00,0x00,0x00,0x00,0x00,0x00,0x00,0x00,0x00,0x00,0x00,0x00,0x00,0x00,0x00,0x00
	.DB 0x00,0x00,0x00,0x00,0x00,0x00,0x00,0x00,0x00,0x00,0x00,0x00,0x00,0x00,0x00,0x00
	.DB 0x00,0x00,0x55,0x10,0x10,0x10,0x24,0x24,0x10,0x24,0x24,0x24,0x00,0x00,0x00,0x10
	.DB 0x00,0x00,0x10,0x10,0x00,0x10,0x10,0x24,0x00,0x24,0x00,0x24,0x24,0x00,0x24,0x00
	.DB 0x00,0x10,0x24,0x00,0x00,0x10,0x24,0x24,0x10,0x00,0x10,0xff,0xff,0xfc,0x3f,0x24
	.DB 0x00,0x00,0x00,0x00,0x00,0x00,0x00,0x00,0x00,0x00,0x00,0x00,0x00,0x00,0x00,0x00
	.DB 0x00,0x00,0x00,0x00,0x00,0x00,0x00,0x00,0x00,0x00,0x00,0x00,0x00,0x00,0x00,0x10
